lemonotype/walker/(commit log)

2026-08-07 Walker v1.0 — open-source LifeSpan treadmill console replacement
    ESP32 firmware (Modbus RTU master + BLE FTMS server), brutalist iOS app
    (SwiftUI, HealthKit, Live Activity) and Android app (Compose, Health
    Connect, signed APK), full reverse-engineering documentation of the
    TR1000-DT 7-pin console interface: separate-line 5V UART, 12V supply +
    enable-sense pair, weak 5V bias rail, register map, and the field lessons
    (EMI-tolerant liveness watchdog, no BLE indications from callbacks,
    delta-capped counters).
    [MainActivity.kt, lifespan_console.ino]
2026-08-07 Add wiring diagram (SVG) to docs and README
2026-08-07 As-built wiring: buck powered from brown 12V with green as ground return
    Diagram + README updated to the final installed configuration; VIN/HV
    jumper and twisted-pair advice removed; capacitor discharge warning added;
    credit line updated in apps, docs and release.
